shkmizu/robo-tars/versao_final/README.md

# TARS — versão final (IA + Bluetooth)

Código para a apresentação: o robô conversa com a IA do notebook pelo **Bluetooth HC-05** (ou pelo cabo USB) e, sem notebook, faz a coreografia sozinho.

A versão de teste continua em `arduino/robo_bracos/` e `ia/tars.py`, sem mudanças.

| Pasta | O que é |
|---|---|
| `arduino/tars_ia/tars_ia.ino` | programa do Arduino (servos no PCA9685, tela OLED, HC-05) |
| `ia/tars.py` | programa do notebook: ouve, pergunta à IA (Ollama), fala e manda o robô agir |
| `ia/requirements.txt` | bibliotecas Python |

## O que muda em relação à versão de teste

| | Teste (`robo_bracos`) | Final (`tars_ia`) |
|---|---|---|
| Coreografia enquanto a IA ouve | volta sozinha depois de 30 s sem comando | fica **desligada** durante a conversa (comando `m 0`) |
| Ao sair do `tars.py` ("desligar" ou Ctrl+C) | nada muda | o robô **volta à coreografia** (`m 1`) |
| Novo comando | — | `m 0` / `m 1`: modo autônomo desligado / ligado; ações novas `andar`, `roda`, `piada`, `duvida`, `susto` |

Sem o notebook, os dois funcionam igual: ao ligar as pilhas, o robô faz a coreografia sozinho.

## Ligações (montagem final)

| De | Para |
|---|---|
| Uno **A4 / A5 / 5V / GND** | PCA9685 **SDA / SCL / VCC / GND** (conector de pinos dobrados) |
| Uno **SDA / SCL** (os 2 pinos ao lado do AREF), **3.3V**, **GND** | OLED **SDA / SCK / VDD / GND** |
| Servo braço direito / esquerdo | PCA9685 **canal 0 / 1** (marrom na fileira preta, GND) |
| Pilhas **+ / −** | **borne verde V+ / GND** do PCA9685 (confira o "V+": se os servos não mexem, inverta) |
| Borne **V+** (junto com o fio das pilhas) | Uno **Vin** (jumper macho-macho) |
| HC-05 **+5V / GND / TX** | Uno **5V** (ao lado do RES) / **GND** / **D10** |
| Uno **D11** → **1 kΩ** → HC-05 **RX** | e do RX → **2 kΩ** → **GND** (o RX do HC-05 é de 3,3 V) |

❌ Nunca ligue as pilhas no pino **5V** do Uno.

## Carregar no Arduino

1. Arduino IDE → *Gerenciar Bibliotecas*: **Adafruit PWM Servo Driver Library** e **Adafruit SSD1306** (com as dependências).
2. Abra `versao_final/arduino/tars_ia/tars_ia.ino`.
3. Calibração: copie para a tabela `juntas[]` os valores `us0` / `us90` que vocês acharam com a versão de teste.
4. *Placa: Arduino Uno*, porta COM do Uno → **Carregar**.
5. Monitor Serial (115200, Nova linha) → RESET: deve aparecer `PCA9685 OK` e `Tela OK`.

## No notebook da apresentação (Windows, baixando do GitHub)

O código está no branch **`claude/relaxed-lamport-gdcxxg`** (ainda não no `main`).

1. **Baixar:** abra https://github.com/shkmizu/robo-tars/archive/refs/heads/claude/relaxed-lamport-gdcxxg.zip (com a conta que tem acesso ao repositório) e descompacte. Ou, no GitHub, troque o branch para `claude/relaxed-lamport-gdcxxg` e use **Code → Download ZIP**.
2. **Instalar uma vez:**
   - **Python 3.12** (instalador direto: https://www.python.org/ftp/python/3.12.10/python-3.12.10-amd64.exe; as versões 3.12 mais novas no site não têm instalador): na instalação, marque **"Add python.exe to PATH"**. Tem que ser o 3.12 (ou 3.11): no Python mais novo o `pyaudio` (microfone) não instala e pede o "Microsoft Visual C++". Se já tem outro Python, pode deixar: os `.bat` escolhem o 3.12 sozinhos.
   - **Ollama** (ollama.com).
   - **Voz em português:** Configurações → Hora e idioma → Fala → Português (Brasil).
3. Na pasta `versao_final/ia`, dê **clique duplo** nos arquivos, nesta ordem:

| Arquivo | O que faz |
|---|---|
| `1_instalar.bat` | instala as bibliotecas, baixa o modelo de IA (~2 GB, só na primeira vez) e roda o autoteste |
| `2_testar_digitando.bat` | conversa digitando, com o robô no USB |
| `3_diagnostico.bat` | confere IA, voz, microfone, internet e robô |
| `4_conversar_por_voz.bat` | **apresentação**: conversa por voz |

Os `.bat` acham sozinhos a porta do Uno no USB (`--porta auto`) e já usam `--baud 115200`. Antes de abrir, ligue o cabo USB no Uno, coloque as pilhas e **feche o Arduino IDE** (o Monitor Serial ocupa a porta).

## Preparar o notebook à mão (Windows)

1. **Ollama** (ollama.com) e o modelo: `ollama pull llama3.2:3b`
2. **Python 3.11 ou 3.12**, e na pasta `versao_final/ia`:
   ```
   pip install -r requirements.txt
   python tars.py --teste
   ```
   Deve aparecer `autoteste ok`.
3. **Voz em português:** Configurações → Hora e idioma → Fala → Português (Brasil).
4. **Parear o HC-05:** Configurações → Bluetooth → Adicionar dispositivo → **HC-05**, senha **1234** (ou 0000). Em *Mais configurações de Bluetooth → Portas COM*, anote a porta **"De saída"** (ex.: COM5).

## Pelo cabo USB, sem Bluetooth (o mais simples)

O HC-05 é opcional: pelo cabo USB a IA comanda o robô do mesmo jeito.
1. Ligue o cabo USB do notebook no Uno (pela janela da tampa traseira). As pilhas continuam no borne verde: elas movem os servos.
2. Descubra a porta: Arduino IDE → *Ferramentas → Porta*, ou Gerenciador de Dispositivos → *Portas (COM e LPT)* → "USB-SERIAL CH340 (COM3)".
3. Feche o Monitor Serial e rode, na pasta `versao_final/ia`, trocando COM3 pela sua porta:
   ```
   python tars.py --porta COM3 --baud 115200 --teclado
   python tars.py --porta COM3 --baud 115200
   ```
   O `--baud 115200` é obrigatório no cabo. Ao abrir a porta o Uno reinicia; o `tars.py` já espera 2 s por isso.

## Usar

Feche o Monitor Serial do Arduino IDE antes (ele ocupa a porta). Na pasta `versao_final/ia`:

| Para | Comando |
|---|---|
| Testar a IA sem robô | `python tars.py --sem-robo --teclado` |
| Robô pelo Bluetooth, digitando | `python tars.py --porta COM5 --teclado` |
| Conferir tudo antes de apresentar | `python tars.py --porta COM5 --diagnostico` |
| **Apresentação, por voz** | `python tars.py --porta COM5` |
| Pelo cabo USB, achando a porta sozinho | `python tars.py --porta auto --baud 115200` |
| Sem internet | acrescente `--vosk vosk-model-small-pt-0.3` (modelo em alphacephei.com/vosk/models) |

Na conversa, a tela mostra **OUVINDO… → PENSANDO… → a resposta**, o notebook fala e os braços fazem a ação. "Oi, TARS" sempre acena, "Dança pra gente" sempre dança e "Parabéns" sempre comemora, mesmo se a IA falhar. Diga **"desligar"** para encerrar: o robô volta à coreografia.

Para mudar o jeito do TARS falar, edite `PERSONALIDADE` no topo de `ia/tars.py`.

## Gestos e falas do filme

| Diga | O TARS faz |
|---|---|
| "Caminhe" / "Anda" | **andar**: balança os blocos como no filme |
| "Rola" / "Modo roda" | **roda**: os blocos giram juntos |
| "Conta uma piada" | **piada**: a tela pisca (a "luz de piada") |
| "Ajuste o humor para 60%" | muda o humor da IA e mostra `HUMOR 60%` na tela |
| "Honestidade 100 por cento" | muda a honestidade da IA |
| "Qual o seu nível de humor?" | informa o ajuste atual |
| "Quem é você?" / "Se apresente" | apresentação do TARS |
| "Você está brincando?" | fala da luz de piada |
| "Isso não é possível" | "Não. É necessário." |
| "Posso confiar em você?" | fala da honestidade |

As falas do filme e os ajustes respondem na hora, sem esperar a IA. Para criar outras, edite a lista `FILME` em `ia/tars.py`. A IA também pode escolher sozinha os gestos novos (`duvida`, `susto`, …).

O `tars.py` gera o áudio antes de mandar o gesto, então os braços e a voz começam juntos.

## Voz do TARS

O TARS fala com uma voz neural da Microsoft (`edge-tts`). Ela precisa de internet; sem internet, o `tars.py` passa sozinho para a voz do Windows (ou rode com `--voz-offline`).

**Escolher a voz:** dê clique duplo em `5_escolher_voz.bat` (ou `python tars.py --escolher-voz`). Digite um número para ouvir a amostra e `g` + número (ex.: `g4`) para gravar. A escolha fica em `ia/voz.txt`.

| Nº | Voz | Como é |
|---|---|---|
| 1 | `pt-BR-AntonioNeural` | masculina, brasileira (padrão) |
| 2 | `pt-BR-FranciscaNeural` | feminina, brasileira |
| 3 | `pt-BR-ThalitaMultilingualNeural` | feminina, brasileira, a mais nova e expressiva |
| 4 | `en-US-AndrewMultilingualNeural` | masculina, multilíngue, bem natural (pode ter leve sotaque) |
| 5 | `en-US-BrianMultilingualNeural` | masculina, multilíngue, descontraída |
| 6 | `en-US-AvaMultilingualNeural` | feminina, multilíngue |

| 7 | ElevenLabs **Brian** | masculina, multilíngue (funciona no plano grátis) |
| 8–11 | ElevenLabs **Talis**, **Fabio Oliveira**, **Thiago Morais**, **Sávio** | brasileiras (vozes da biblioteca: pela API pedem plano pago, a partir do Starter) |

**ElevenLabs:** crie a conta em elevenlabs.io → *Developers* → *API Keys* → crie uma chave com permissão de *Text to Speech*. Na primeira vez que escolher uma voz [ElevenLabs] no `5_escolher_voz.bat`, ele pede a chave e guarda em `ia/elevenlabs_chave.txt` (fora do GitHub). O plano grátis dá ~10 mil caracteres por mês (umas 100 respostas do TARS). Se a ElevenLabs falhar (internet, créditos, plano), o TARS passa sozinho para a voz da Microsoft. `ELEVEN_MODELO` no topo de `ia/tars.py`: `eleven_flash_v2_5` (padrão, responde mais rápido) ou `eleven_multilingual_v2` (mais natural, mas demora mais). A fala da ElevenLabs começa a tocar enquanto o resto ainda chega, e o `tars.py` mantém a saída de som aberta (tocando silêncio) para o Windows não cortar o começo das frases.

`TOM` e `VELOCIDADE` no topo de `ia/tars.py` mudam o tom e o ritmo (ex.: `-10Hz`, `-5%`), mas qualquer mudança deixa a voz menos natural.
