shkmizu/robo-tars/arduino/tinkercad/TINKERCAD.md

# Testar o código do TARS no Tinkercad

O Tinkercad Circuits não tem o PCA9685, o OLED SSD1306 nem o Bluetooth HC-05. Por isso este teste usa o [`tinkercad_tars.ino`](tinkercad_tars.ino), que tem **a mesma lógica** do `robo_bracos.ino` (comandos, ações, limites, movimento suave) com o hardware trocado:

| No robô | No Tinkercad |
|---|---|
| PCA9685 + 2 SG90 | 2 × **Micro servo** direto nos pinos **9** e **10** |
| OLED SSD1306 | **LCD 16 x 2 (I2C)** |
| HC-05 (comandos do `tars.py`) | **Monitor Serial** (você digita os comandos) |

## Montar o circuito

1. Entre em tinkercad.com → **Circuitos → Criar novo circuito**.
2. Arraste para a área de trabalho: **Arduino Uno R3**, 2 × **Micro servo** e 1 × **LCD 16 x 2 (I2C)**.
3. Ligue os fios:

   | Componente | Pino | Arduino |
   |---|---|---|
   | Servo 1 (braço D) | Sinal | **D9** |
   | Servo 2 (braço E) | Sinal | **D10** |
   | Servos | Potência / Terra | **5V** / **GND** |
   | LCD I2C | GND / VCC | **GND** / **5V** |
   | LCD I2C | SDA / SCL | **A4** / **A5** |

4. Clique em **Código → Texto** (confirme a troca), apague o que estiver lá e cole o conteúdo de `tinkercad_tars.ino`.
5. Clique em **Iniciar simulação** e abra o **Monitor Serial** (embaixo do código).

## Testes

Ao iniciar a simulação, o robô entra no **modo autônomo**: os servos seguem a coreografia sozinhos e o Monitor Serial mostra cada texto da tela (`[tela] ...`). Os comandos funcionam do mesmo jeito. Depois de cada comando, a coreografia espera 30 s (no relógio da simulação) e continua. Para testar os comandos com calma, mande `d` antes.

Digite cada comando no Monitor Serial e clique em **Enviar**:

| Comando | Resultado esperado | O que testa |
|---|---|---|
| `a saudar` | servo 1 acena 3 vezes; LCD: "OLA! :)"; Monitor: `ok` | ação de cumprimento |
| `a dancar` | servos alternam (passada); LCD: "MODO DANCA" | ação de dança |
| `a sim` / `a nao` | servos balançam juntos / alternados | respostas da IA |
| `t Ola turma` | LCD mostra "Ola turma" | mensagens da IA na tela |
| `j 0 45` | servo 1 vai para 45°; `ok junta 0 em 45.00` | comando de ângulo |
| `j 0 150` | servo 1 para em **90** (`em 90.00`) | **limite de segurança** |
| `j 1 -60` | servo 2 vai para −60° | sentido espelhado do braço E |
| `a voar` | `erro acao: voar` | ação inválida não trava |
| `x` | `erro comando` | comando inválido não trava |
| `d` | desliga o modo autônomo (LCD: "PRONTO"); `d` de novo liga e recomeça da cena 1 | modo autônomo |

Os comandos `a ...` e `t ...` são exatamente o que o `tars.py` manda ao robô pelo Bluetooth. Se eles funcionarem aqui, a parte do Arduino está certa.

## Se algo não funcionar

- **LCD apagado ou sem texto:** clique no LCD e, no painel de propriedades, escolha o tipo **MCP23008** e o endereço **32** (0x20). O sketch usa a biblioteca `Adafruit_LiquidCrystal`, que só fala com esse tipo.
- **Ângulo do servo na tela:** o Micro servo do Tinkercad mostra 0–180°. O braço em pé (0° no sketch, 1500 µs) aparece como **~90°** no Tinkercad.
- **Movimento lento:** a simulação costuma rodar mais devagar que o tempo real (veja o relógio no canto). As ações demoram mais que no robô, mas a sequência é a mesma.
- **Comando ignorado:** confira se a simulação está rodando e se o texto não tem espaço sobrando no começo.

## O que o Tinkercad NÃO testa

- o PCA9685, o OLED e o HC-05 de verdade (a fiação e as bibliotecas reais);
- a memória: o Uno real tem a tela OLED, que ocupa 1 KB a mais;
- a voz e a IA (`tars.py`), que rodam no notebook.

Esses só se confirmam com o robô montado: siga a Fase 8 do [MONTAGEM.md](../../MONTAGEM.md).
