shkmizu/robo-tars/laser/chapa_1.dxf

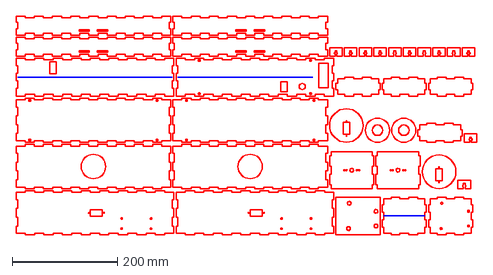
[picture p1: CAD file, 2026-10-15]
laser/chapa_1.dxf
876.0 x 416.0 mm
