shkmizu/robo-tars/laser/pecas/12_Braco_topo-fundo_x4.dxf

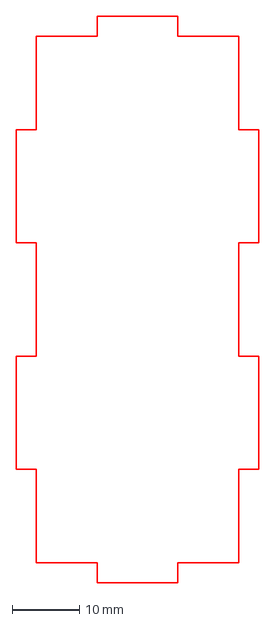
[picture p2: CAD file, 2026-10-15]
laser/pecas/12_Braco_topo-fundo_x4.dxf
36.0 x 84.0 mm
