shkmizu/robo-tars/laser/00_pente_de_teste.dxf

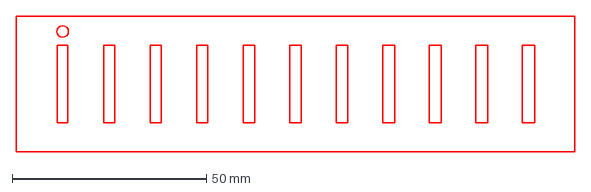
[picture p3: CAD file, 2026-10-15]
laser/00_pente_de_teste.dxf
144.0 x 35.0 mm
