shkmizu/robo-tars/laser/pecas/06_Corpo_fundo_x1.dxf

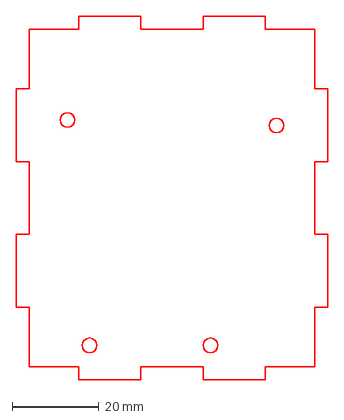
[picture p4: CAD file, 2026-10-15]
laser/pecas/06_Corpo_fundo_x1.dxf
72.0 x 84.0 mm
