shkmizu/robo-tars/laser/pecas/01_Base_x1.dxf

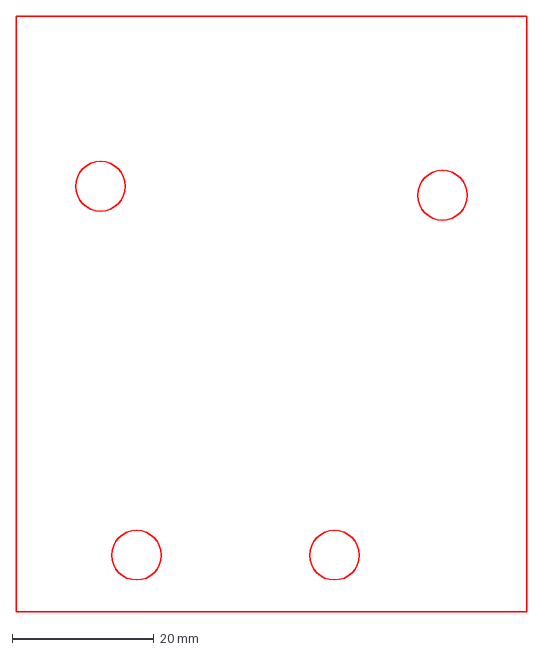
[picture p5: CAD file, 2026-10-15]
laser/pecas/01_Base_x1.dxf
72.0 x 84.0 mm
