shkmizu/robo-tars/laser/pecas/03_Corpo_tras_tampa_x1.dxf

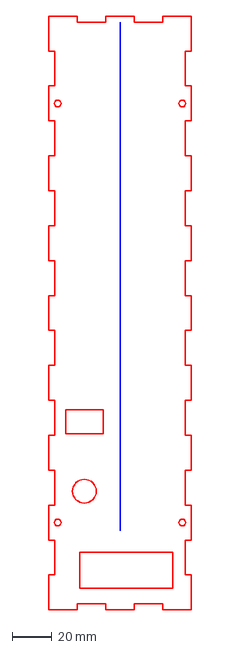
[picture p6: CAD file, 2026-10-15]
laser/pecas/03_Corpo_tras_tampa_x1.dxf
72.0 x 300.0 mm
