shkmizu/robo-tars/laser/pecas/04_Corpo_lateral_x2.dxf

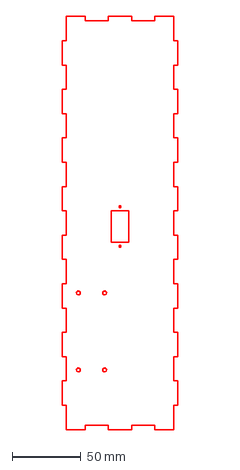
[picture p7: CAD file, 2026-10-15]
laser/pecas/04_Corpo_lateral_x2.dxf
84.0 x 300.0 mm
