shkmizu/robo-tars/laser/pecas/02_Corpo_frente_x1.dxf

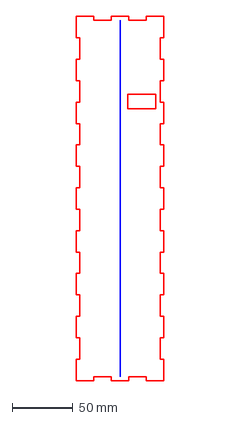
[picture p8: CAD file, 2026-10-15]
laser/pecas/02_Corpo_frente_x1.dxf
72.0 x 300.0 mm
