shkmizu/robo-tars/laser/pecas/15_Reforco_do_braco_x8.dxf

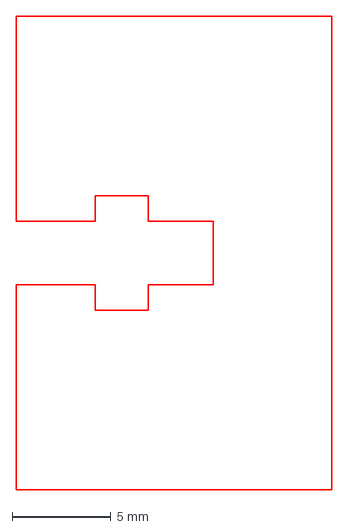
[picture p9: CAD file, 2026-10-15]
laser/pecas/15_Reforco_do_braco_x8.dxf
16.0 x 24.0 mm
