shkmizu/robo-tars/laser/pecas/09_Braco_frente-tras_x4.dxf

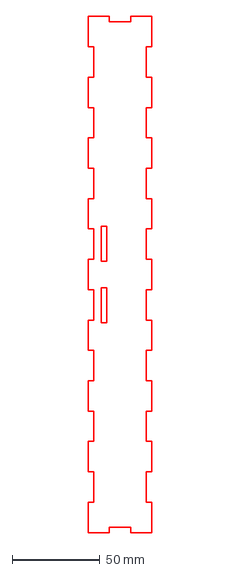
[picture p10: CAD file, 2026-10-15]
laser/pecas/09_Braco_frente-tras_x4.dxf
36.0 x 294.0 mm
