shkmizu/robo-tars/laser/pecas/13_Anteparo_do_horn_x2.dxf

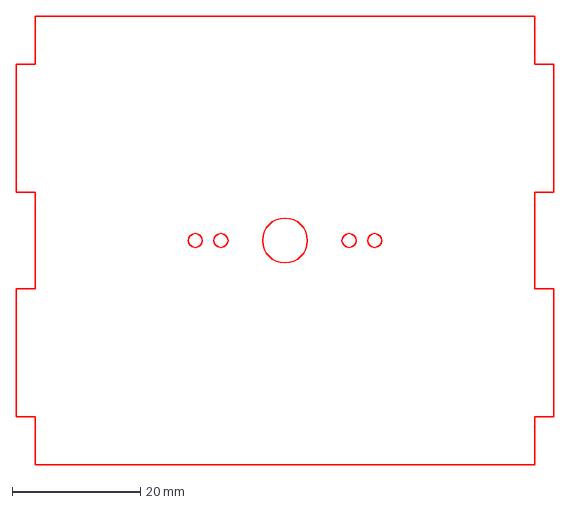
[picture p11: CAD file, 2026-10-15]
laser/pecas/13_Anteparo_do_horn_x2.dxf
84.0 x 70.0 mm
