shkmizu/robo-tars/laser/pecas/11_Braco_lateral_externa_tampa_x2.dxf

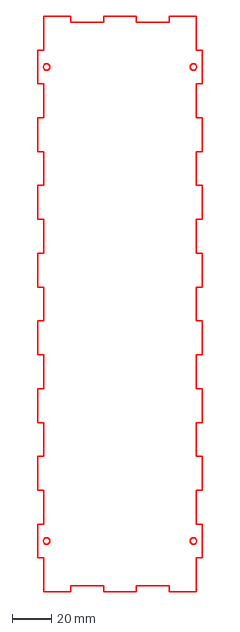
[picture p12: CAD file, 2026-10-15]
laser/pecas/11_Braco_lateral_externa_tampa_x2.dxf
84.0 x 294.0 mm
