shkmizu/robo-tars/laser/pecas/07_Mancal_disco_de_encosto_x2.dxf

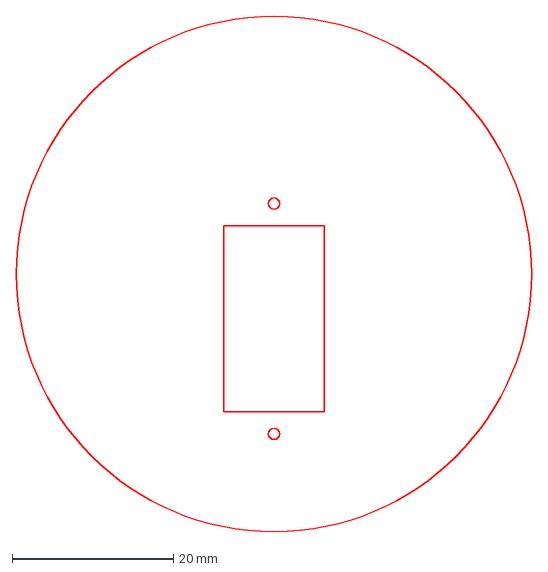
[picture p13: CAD file, 2026-10-15]
laser/pecas/07_Mancal_disco_de_encosto_x2.dxf
64.0 x 64.0 mm
