shkmizu/robo-tars/laser/pecas/05_Corpo_topo_x1.dxf

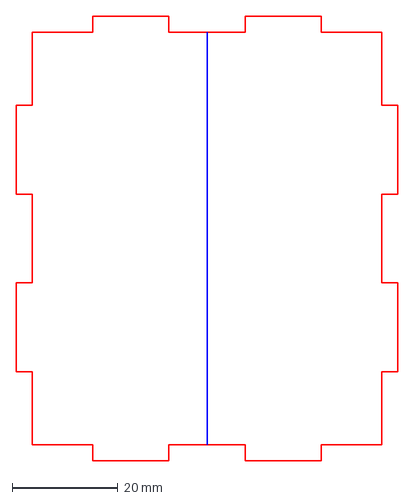
[picture p14: CAD file, 2026-10-15]
laser/pecas/05_Corpo_topo_x1.dxf
72.0 x 84.0 mm
