shkmizu/robo-tars/laser/pecas/08_Mancal_disco_do_eixo_x2.dxf

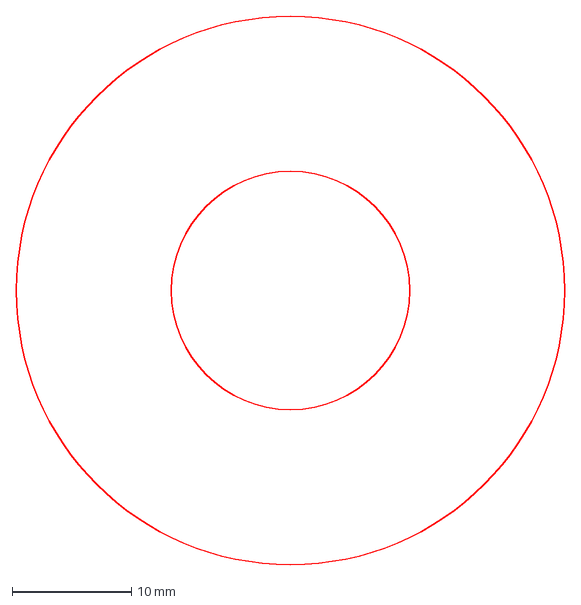
[picture p15: CAD file, 2026-10-15]
laser/pecas/08_Mancal_disco_do_eixo_x2.dxf
46.0 x 46.0 mm
