shkmizu/robo-tars/laser/pecas/10_Braco_lateral_interna_x2.dxf

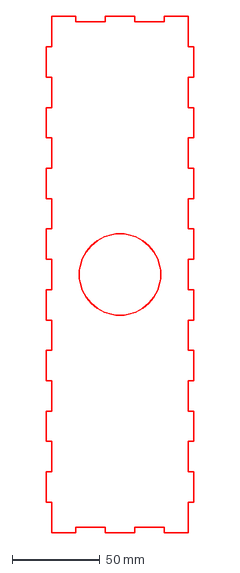
[picture p16: CAD file, 2026-10-15]
laser/pecas/10_Braco_lateral_interna_x2.dxf
84.0 x 294.0 mm
