shkmizu/robo-tars/(commit log)

2026-10-15 Robô TARS: projeto completo para o CP5
    - projeto.py: medidas, geometria das peças e verificações de engenharia
    - laser/: arquivo de corte (chapa 900x600), pente de teste e peças avulsas
    - arduino/: 2 servos SG90 (PCA9685), tela OLED e Bluetooth HC-05
    - ia/tars.py: voz, LLM local (Ollama) e comandos ao robô
    - demo/: demonstração 3D; MONTAGEM.md, FUSION.md e CP5.md
    [00_pente_de_teste.dxf, 01_Base_x1.dxf, 02_Corpo_frente_x1.dxf, 03_Corpo_tras_tampa_x1.dxf, 04_Corpo_lateral_x2.dxf, 05_Corpo_topo_x1.dxf, 06_Corpo_fundo_x1.dxf, 07_Mancal_disco_de_encosto_x2.dxf]
2026-10-15 Versão de teste para o Tinkercad
2026-10-15 Tinkercad: dicas para LCD apagado, ângulo do servo e simulação lenta
    Claude-Session: https://claude.ai/code/session_013P6TeZzgTqzCewtZdJZZuz
2026-10-16 Modo autônomo: coreografia ao ligar, alimentação por pilhas AA NiMH
    - robo_bracos.ino e tinkercad_tars.ino: coreografia em 9 cenas curtas que
    começa sozinha ao ligar; comandos pausam por 30 s, 'u' desliga, 'd' alterna
    - nomes das ações na flash e buffers de linha de 64 bytes (RAM abaixo da versão anterior)
    - tars.py: texto limitado a 60 caracteres para caber no buffer de 64 bytes
    - docs: bateria 4×AA NiMH no lugar da fonte; modo autônomo no README, MONTAGEM, CP5 e Tinkercad
    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
2026-10-16 Energia mais barata: 4 pilhas AA alcalinas, Uno pelo pino Vin
    Alcalinas (6 V) servem para os SG90; o Uno recebe pelo Vin, cujo regulador
    baixa a tensão, e o USB pode ficar ligado junto. NiMH continua documentada
    como alternativa, no pino 5V.
    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
2026-10-18 Ligação do OLED direto no Uno, para PCA9685 com só um conector soldado
    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
2026-10-19 robo_bracos: opção de servos direto no Uno (D9/D6), sem PCA9685
    USAR_PCA9685 escolhe o modo; o padrão agora é 0. Os servos ligam um de cada
    vez para não derrubar o Uno no arranque.
    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
2026-10-19 MONTAGEM: caminho sem PCA9685, testes por componente, encaixe e ensaio geral
    O guia passa a seguir a ordem testar cada componente → testar o encaixe →
    ensaio geral fora do robô → montar. O PCA9685 vira uma variante no fim.
    README aponta para o roteiro de bancada publicado.
    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
2026-10-19 robo_bracos: padrão volta a ser com PCA9685 (USAR_PCA9685 1)
    A montagem final do grupo usa o PCA9685; README e MONTAGEM dizem quando usar 0.
    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
2026-10-20 versao_final: Arduino (tars_ia) e tars.py para IA + Bluetooth
    Pasta separada; a versão de teste continua igual. Novo comando m 0/m 1 liga e
    desliga o modo autônomo de forma explícita; o tars.py desliga a coreografia ao
    conversar (braços quietos perto do microfone) e religa ao sair, inclusive no Ctrl+C.
    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
2026-10-20 versao_final: .bat de clique duplo para Windows e --porta auto
    O notebook da apresentação baixa o repositório e roda 1_instalar.bat,
    2_testar_digitando.bat, 3_diagnostico.bat e 4_conversar_por_voz.bat; o tars.py
    acha sozinho a porta USB do Uno (CH340/Arduino) com --porta auto.
    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
2026-10-26 versao_final: voz neural pt-BR do TARS (edge-tts) com a voz do sistema de reserva
    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
2026-10-26 versao_final: gestos novos, falas do filme, ajuste de humor/honestidade e voz sincronizada com os braços
    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
2026-10-26 versao_final: silêncio no começo da fala para o notebook não cortar o início
    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
2026-10-26 versao_final: voz natural (sem mudar o tom) e 5_escolher_voz.bat para ouvir e escolher a voz
    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
2026-10-26 versao_final: vozes da ElevenLabs no menu de vozes, com a Microsoft e o sistema de reserva
    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
2026-10-26 versao_final: saída de som sempre aberta (não corta o começo) e ElevenLabs em streaming com o modelo flash
    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
